JRussell02/lidar-zed-rig/hardware/tripod_grip_mount.stl

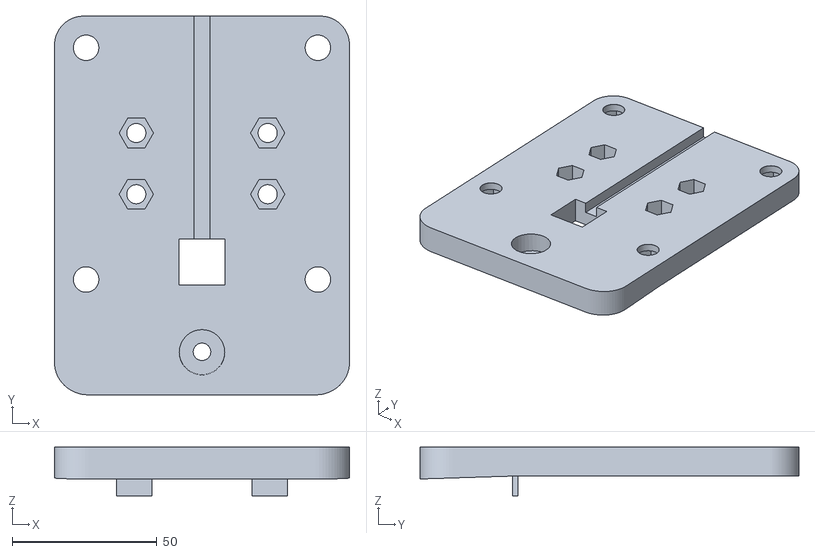
[picture p3: CAD file, 2026-11-05]
hardware/tripod_grip_mount.stl
102.0 x 131.0 x 16.9
