JRussell02/lidar-zed-rig/hardware/hand_grip.stl

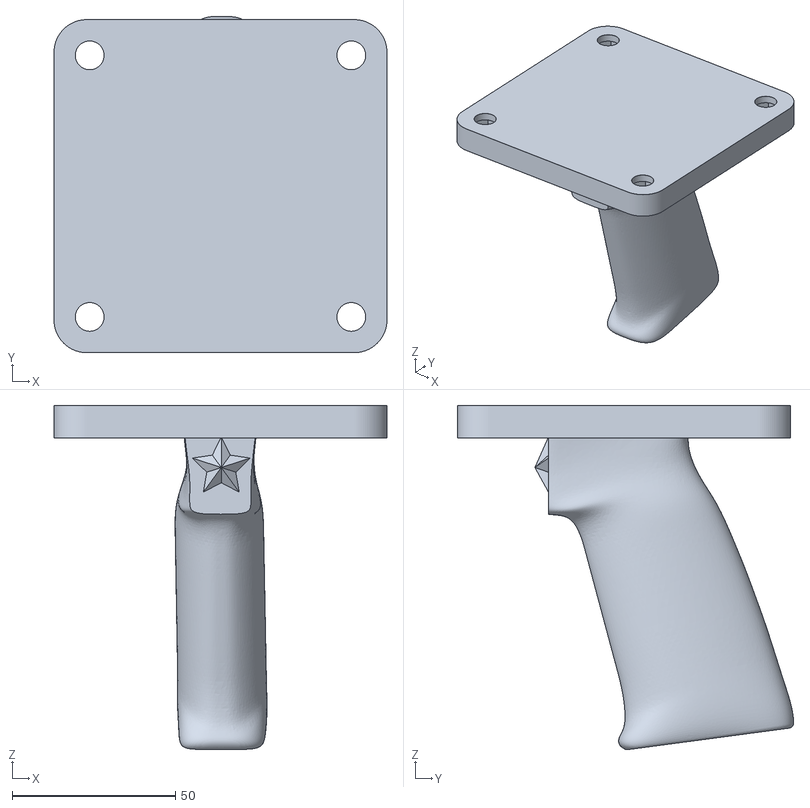
[picture p4: CAD file, 2026-10-29]
hardware/hand_grip.stl
102.0 x 103.0 x 105.5
