JRussell02/lidar-zed-rig/hardware/grip_with_zed_mount.stl

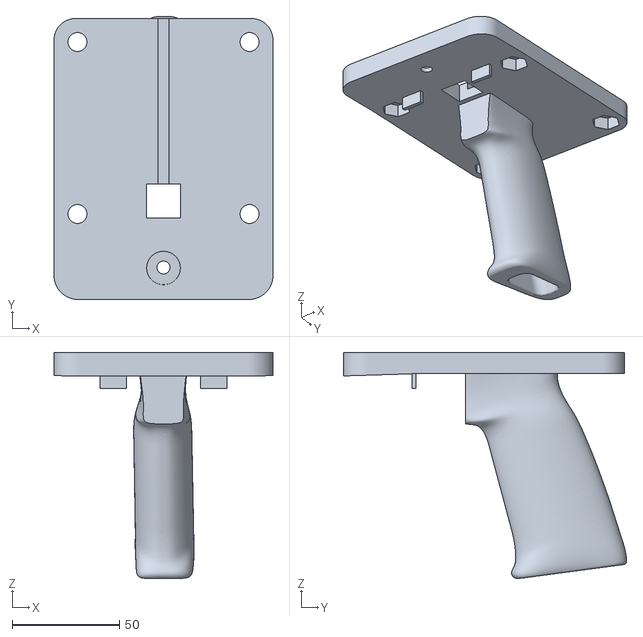
[picture p5: CAD file, 2026-10-29]
hardware/grip_with_zed_mount.stl
102.0 x 132.0 x 105.5
