JRussell02/lidar-zed-rig/(list of files, cad)

Other CAD files:
hardware/mount_handle.blend
hardware/tripod_grip_mount.blend
