JRussell02/lidar-zed-rig/(commit log)

2026-10-29 OS1 + ZED handheld scanning rig: hardware, software, calibration
    - hardware/: 3D-printable grip carrying the OS1 on top and the ZED
    underneath (final STL with the camera mount, original grip, Blender
    source, renders)
    - src/lidarzed/: installable package with commands to record both
    sensors on one clock, view the ZED without its SDK, convert
    recordings for direct_visual_lidar_calibration, check calibrations
    (overlay, edge score, rotation refit, camera delay, height), color
    SLAM'd scans and evaluate scan fidelity
    - calibration/2026-10-28/: camera-LiDAR transform, 26 ms camera delay,
    factory lens calibration and alternatives
    - docker/: headless calibration image (Xvfb) and runner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
    [grip_with_zed_mount.stl, hand_grip.stl, mount_handle.blend]
2026-10-29 Add end-to-end scan pipeline guide
    From power-on to a colored PLY: connecting and checking the sensors,
    recording both with one command, SLAM, colorizing, viewing and optional
    evaluation. Explains that ROS 2 is only used inside Docker for
    calibration, and maps package commands to the older script names.
2026-10-29 Stop recording cleanly on SIGHUP/SIGTERM
    A dropped SSH session sends SIGHUP; previously that killed the recorder
    while ouster-cli (in its own process group) kept recording unattended.
    Now SIGHUP and SIGTERM stop both sensors like Ctrl+C.
2026-10-29 Keep nohup recordings alive on SSH disconnect
    Only install the SIGHUP handler when SIGHUP isn't already ignored, so
    'nohup lidarzed-record ... &' keeps recording after a disconnect while a
    plain run still stops cleanly.
2026-10-30 Keep colors when merging scans with lidarzed-eval align
    read colorize PLYs (float xyz + uchar rgb), average colors per merge voxel
    and write a colored merged PLY.
2026-11-05 Add SLAM path check, global alignment and keep-all-points colorizing
    - lidarzed-eval path: path height span, tilt and jumps after SLAM; flags
    "SLAM probably lost track" (height span > 2 m or a jump > 0.5 m)
    - lidarzed-eval align --global: level both clouds, match wall floor plans
    over a yaw grid (FFT cross-correlation), then ICP; for scans that didn't
    start on the same spot or heading
    - lidarzed-colorize --all-points: keep LiDAR points the camera didn't see
    (gray, PLY property colored = 0); merging colors them from other scans
    - Faster voxel averaging (packed keys + bincount); render reads any PLY
2026-11-05 Stop when the ZED falls back from 720p, e.g. on a USB 2 link
    lidarzed-snapshot saved VGA side-by-side frames without noticing; record
    and snapshot now share one check that names the USB speed. The recorder
    only says "(disk too slow)" when frames were actually dropped.
2026-11-05 Add tripod-grip version of the mount
    Same plate, OS1 pattern and ZED mount as the grip (within 0.5 mm in CAD),
    handle removed and four holes for a tripod grip added.
    [tripod_grip_mount.blend, tripod_grip_mount.stl]
2026-11-06 Let ouster-cli stop cleanly when recording under nohup
    A recording started with `nohup lidarzed-record ... &` inherits SIGINT as
    ignored, and so did ouster-cli: it never reacted to the stop signal, hung
    30 s, was killed, and left the OSF metadata unfinalized. Reset SIGINT to
    the default in the ouster-cli child.
2026-11-06 Recalibrate for the tripod-grip mount and make it the default
    New calibration/2026-11-05 (tri-calib01-05 jointly, from the 28 Oct
    result): 0.61 deg and ~6 mm from 28 Oct; edge alignment 3.56 -> 2.56 px
    on the new recordings; single-recording rotations within 0.15 deg; box
    height test agrees within 3 mm. Report in
    docs/calibration-report-2026-11-05.md.
    lidarzed-colorize, lidarzed-record and the docs now default to
    calibration/2026-11-05; docker/vlcal.sh is executable.
2026-11-06 Measure SLAM path height against true vertical, not the start pose
    lidarzed-eval path measured height along the first pose's up, so a pass
    held tilted from the start (e.g. 25° toward the floor) looked like meters
    of height change and was flagged as lost tracking. It now finds true up
    from the floor/ceiling normals of a sparse SLAM map and reports height and
    tilt from vertical. On real scans: tilted passes now 2–7 cm instead of
    2–3 m; the genuinely lost floor/roof scans of Nov 3 are still flagged.
    level() (used by align --global) shares the new up_direction(), replacing
    the mean-normal estimate that left ~3° of residual tilt.
2026-11-06 Print tilt and total rotation in the align ICP correction, not just yaw
